TeamMacLean/Automator/hardware/Schematic Automator .pdf

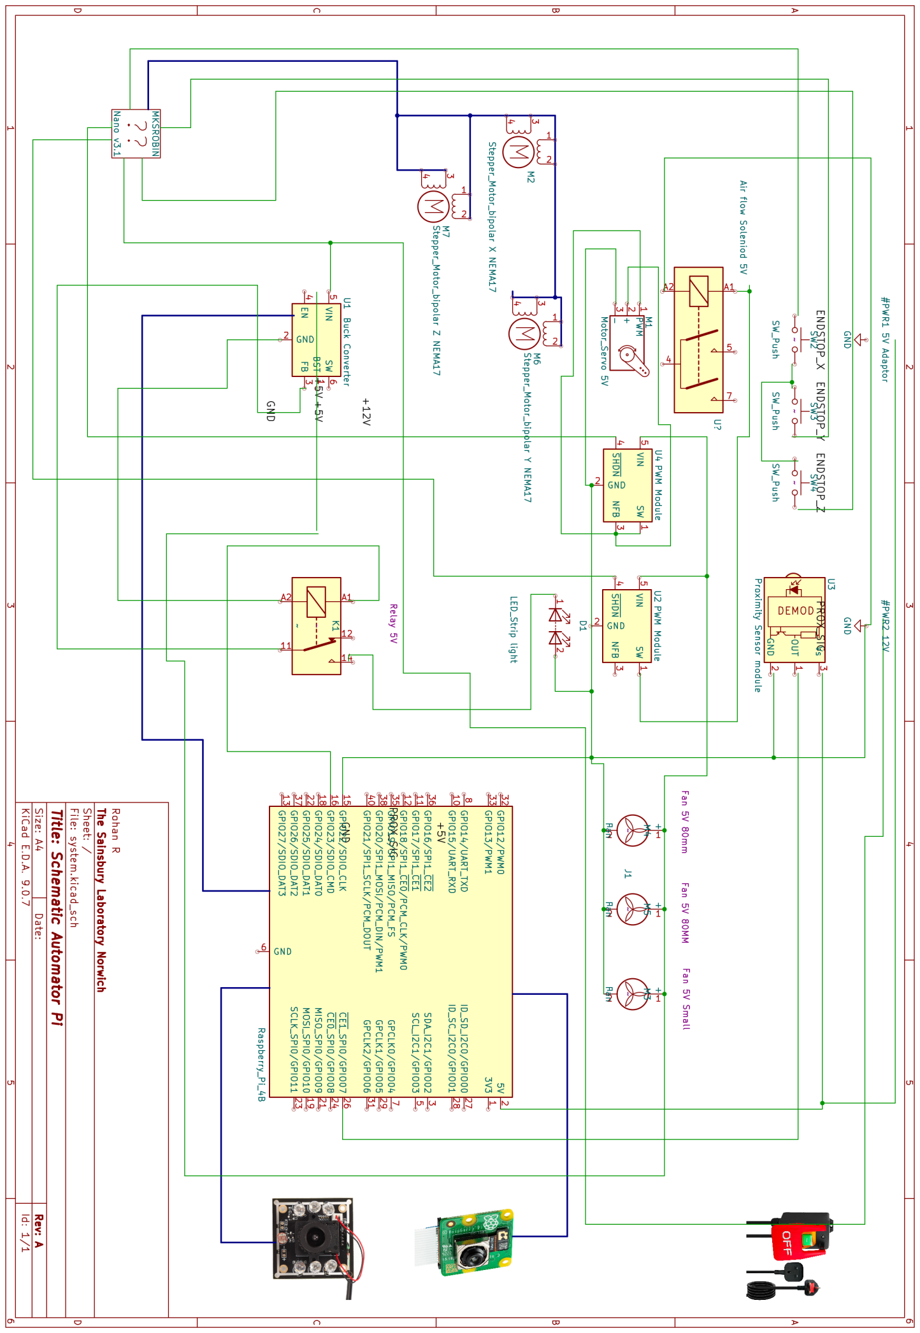
[picture p46: page 1]
