TeamMacLean/Automator/mechanical/LED_and_cam_case.stl

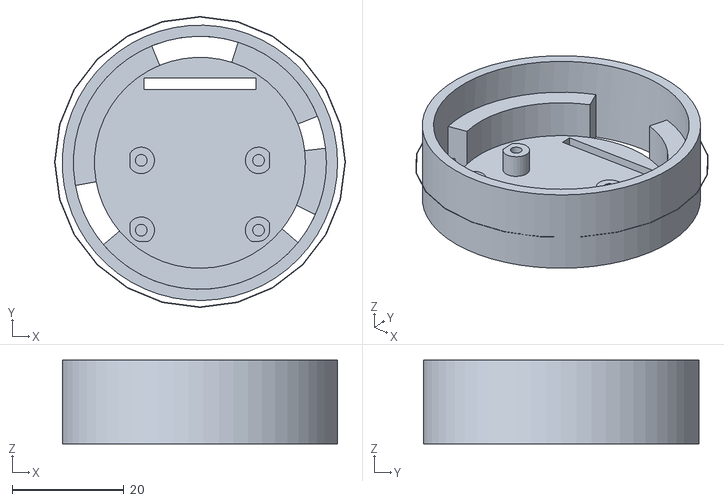
[picture p47: CAD file, 2026-07-26]
mechanical/LED_and_cam_case.stl
52.1 x 52.1 x 15.0
