TeamMacLean/Automator/mechanical/Base_LED_and_cam_case.stl

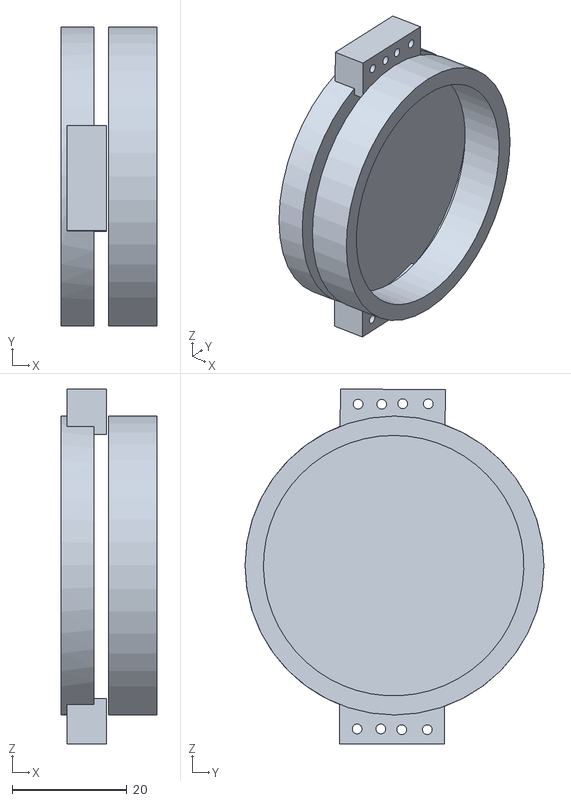
[picture p48: CAD file, 2026-07-26]
mechanical/Base_LED_and_cam_case.stl
16.7 x 52.0 x 61.8
