TeamMacLean/Automator/mechanical/Base_PIMKS.stl

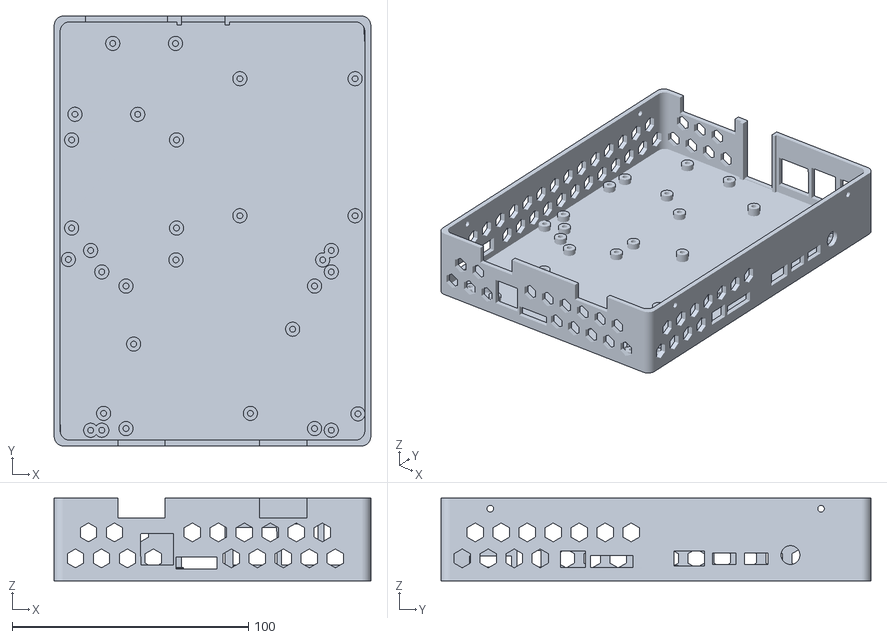
[picture p49: CAD file, 2026-07-26]
mechanical/Base_PIMKS.stl
134.0 x 182.0 x 35.0
