TeamMacLean/Automator/mechanical/Cover_80mm_Two_Fans.stl

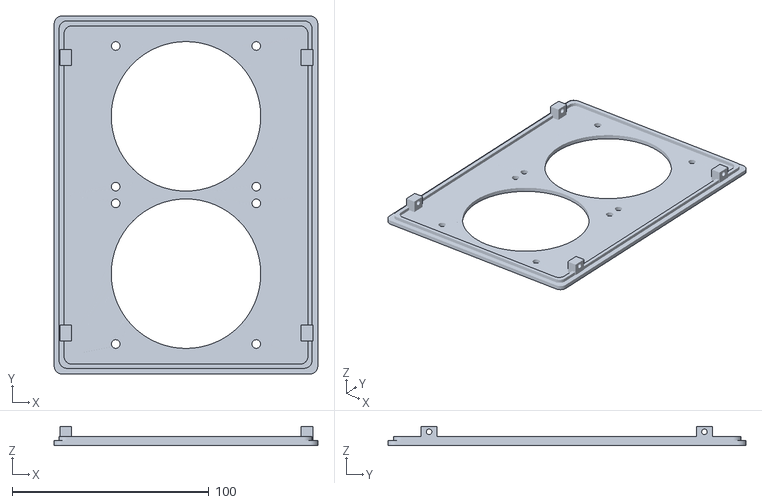
[picture p50: CAD file, 2026-07-26]
mechanical/Cover_80mm_Two_Fans.stl
134.0 x 182.0 x 9.68
