TeamMacLean/Automator/hardware/system schematic Automator.kicad_sch

## KiCad design hardware/system schematic Automator.kicad_sch (2026-07-26)

Schematic: system schematic Automator.kicad_sch

Parts:
D1: LED_Strip light
J1: Raspberry_Pi_4B
K1: (no value)
M1: Motor_Servo 5V
M2: Stepper_Motor_bipolar X NEMA17
M3, M4, M5: Fan
M6: Stepper_Motor_bipolar Y NEMA17
M7: Stepper_Motor_bipolar Z NEMA17
MKSROBIN: Nano v3.1
SW2, SW3, SW4: SW_Push
U1: Buck Converter; SOT-23-6
U2, U4: PWM Module; SOT-23-5
U3: Proximity Sensor module; Vishay_MINICAST-3Pin
