TeamMacLean/Automator/config/NetworkManager/preconfigured.nmcli.txt

connection.id:                          preconfigured
connection.uuid:                        e70013c7-5a59-4385-a157-2e4f6a428f69
connection.stable-id:                   --
connection.type:                        802-11-wireless
connection.interface-name:              --
connection.autoconnect:                 yes
connection.autoconnect-priority:        0
connection.autoconnect-retries:         -1 (default)
connection.multi-connect:               0 (default)
connection.auth-retries:                -1
connection.timestamp:                   1754864691
connection.read-only:                   no
connection.permissions:                 --
connection.zone:                        --
connection.master:                      --
connection.slave-type:                  --
connection.autoconnect-slaves:          -1 (default)
connection.secondaries:                 --
connection.gateway-ping-timeout:        <REDACTED>
connection.metered:                     unknown
connection.lldp:                        default
connection.mdns:                        -1 (default)
connection.llmnr:                       -1 (default)
connection.dns-over-tls:                -1 (default)
connection.mptcp-flags:                 0x0 (default)
connection.wait-device-timeout:         -1
connection.wait-activation-delay:       -1
802-11-wireless.ssid:                   SHELL-4CB4D3
802-11-wireless.mode:                   infrastructure
802-11-wireless.band:                   --
802-11-wireless.channel:                0
802-11-wireless.bssid:                  --
802-11-wireless.rate:                   0
802-11-wireless.tx-power:               0
802-11-wireless.mac-address:            --
802-11-wireless.cloned-mac-address:     --
802-11-wireless.generate-mac-address-mask:--
802-11-wireless.mac-address-blacklist:  --
802-11-wireless.mac-address-randomization:default
802-11-wireless.mtu:                    auto
802-11-wireless.seen-bssids:            8C:FD:DE:4C:B4:D1,8C:FD:DE:4C:B4:D0
802-11-wireless.hidden:                 no
802-11-wireless.powersave:              0 (default)
802-11-wireless.wake-on-wlan:           0x1 (default)
802-11-wireless.ap-isolation:           -1 (default)
802-11-wireless-security.key-mgmt:      wpa-psk
802-11-wireless-security.wep-tx-keyidx: 0
802-11-wireless-security.auth-alg:      --
802-11-wireless-security.proto:         --
802-11-wireless-security.pairwise:      --
802-11-wireless-security.group:         --
802-11-wireless-security.pmf:           0 (default)
802-11-wireless-security.leap-username: --
802-11-wireless-security.wep-key0:      <REDACTED>
802-11-wireless-security.wep-key1:      <REDACTED>
802-11-wireless-security.wep-key2:      <REDACTED>
802-11-wireless-security.wep-key3:      <REDACTED>
802-11-wireless-security.wep-key-flags: <REDACTED>
802-11-wireless-security.wep-key-type:  <REDACTED>
802-11-wireless-security.psk:           <REDACTED>
802-11-wireless-security.psk-flags:     <REDACTED>
802-11-wireless-security.leap-password: <REDACTED>
802-11-wireless-security.leap-password-flags:<REDACTED>
802-11-wireless-security.wps-method:    0x0 (default)
802-11-wireless-security.fils:          0 (default)
ipv4.method:                            auto
ipv4.dns:                               --
ipv4.dns-search:                        --
ipv4.dns-options:                       --
ipv4.dns-priority:                      0
ipv4.addresses:                         --
ipv4.gateway:                           --
ipv4.routes:                            --
ipv4.route-metric:                      -1
ipv4.route-table:                       0 (unspec)
ipv4.routing-rules:                     --
ipv4.replace-local-rule:                -1 (default)
ipv4.ignore-auto-routes:                no
ipv4.ignore-auto-dns:                   no
ipv4.dhcp-client-id:                    --
ipv4.dhcp-iaid:                         --
ipv4.dhcp-timeout:                      0 (default)
ipv4.dhcp-send-hostname:                yes
ipv4.dhcp-hostname:                     --
ipv4.dhcp-fqdn:                         --
ipv4.dhcp-hostname-flags:               0x0 (none)
ipv4.never-default:                     no
ipv4.may-fail:                          yes
ipv4.required-timeout:                  -1 (default)
ipv4.dad-timeout:                       -1 (default)
ipv4.dhcp-vendor-class-identifier:      --
ipv4.link-local:                        0 (default)
ipv4.dhcp-reject-servers:               --
ipv4.auto-route-ext-gw:                 -1 (default)
ipv6.method:                            auto
ipv6.dns:                               --
ipv6.dns-search:                        --
ipv6.dns-options:                       --
ipv6.dns-priority:                      0
ipv6.addresses:                         --
ipv6.gateway:                           --
ipv6.routes:                            --
ipv6.route-metric:                      -1
ipv6.route-table:                       0 (unspec)
ipv6.routing-rules:                     --
ipv6.replace-local-rule:                -1 (default)
ipv6.ignore-auto-routes:                no
ipv6.ignore-auto-dns:                   no
ipv6.never-default:                     no
ipv6.may-fail:                          yes
ipv6.required-timeout:                  -1 (default)
ipv6.ip6-privacy:                       -1 (unknown)
ipv6.addr-gen-mode:                     default
ipv6.ra-timeout:                        0 (default)
ipv6.mtu:                               auto
ipv6.dhcp-duid:                         --
ipv6.dhcp-iaid:                         --
ipv6.dhcp-timeout:                      0 (default)
ipv6.dhcp-send-hostname:                yes
ipv6.dhcp-hostname:                     --
ipv6.dhcp-hostname-flags:               0x0 (none)
ipv6.auto-route-ext-gw:                 -1 (default)
ipv6.token:                             <REDACTED>
proxy.method:                           none
proxy.browser-only:                     no
proxy.pac-url:                          --
proxy.pac-script:                       --
