TeamMacLean/Automator/(commit log)

2026-08-07 Add move procedure for relocating the Automator
    Shutdown, umbilical disconnection, and rebuild steps for moving the
    system out of the growth chamber to temporary storage.
2026-08-07 Record damage from 2026-08-07 move; flag move procedure as partly superseded
    The umbilical could not be withdrawn intact due to undocumented cable
    ties, inline splices, and knots in the as-built wiring. Wires were cut
    near connectors and the 3D-printed cradle was destroyed. Rebuild now
    requires re-termination, a re-printed cradle, and full recalibration.
