TeamMacLean/Automator/(notices)

Notices in the files:
README.md:
Hardware License: CERN-OHL-S-2.0
Docs License: CC BY 4.0
