TeamMacLean/Automator/hardware/images/estop.jpg

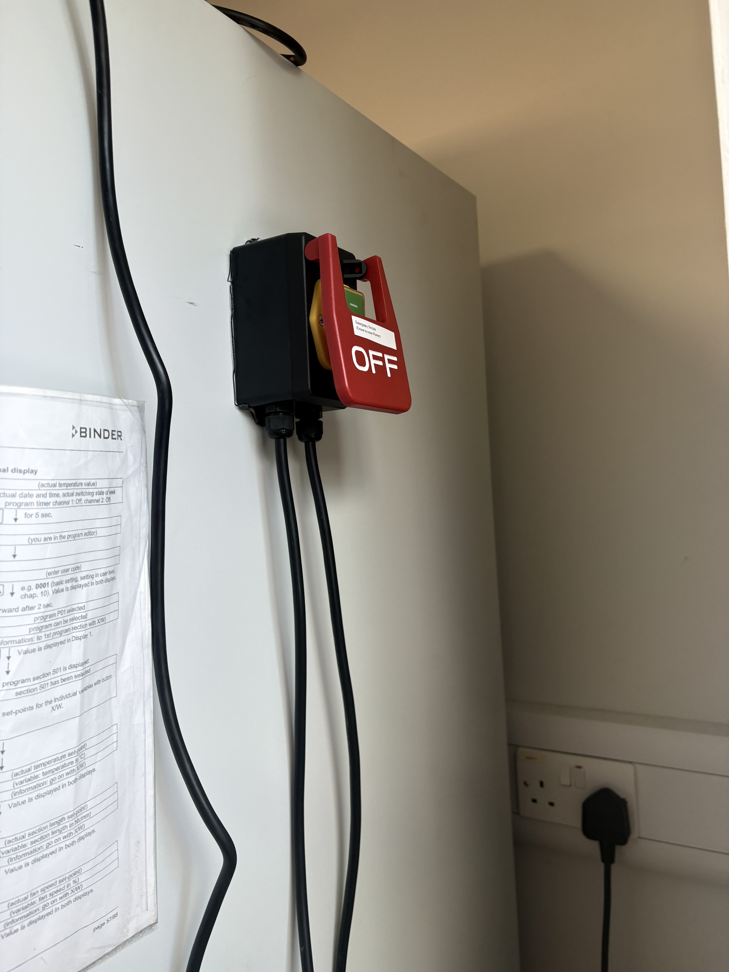
[picture p6: hardware/images/estop.jpg]
hardware/images/estop.jpg
