TeamMacLean/Automator/mechanical/IMG_5643.JPG

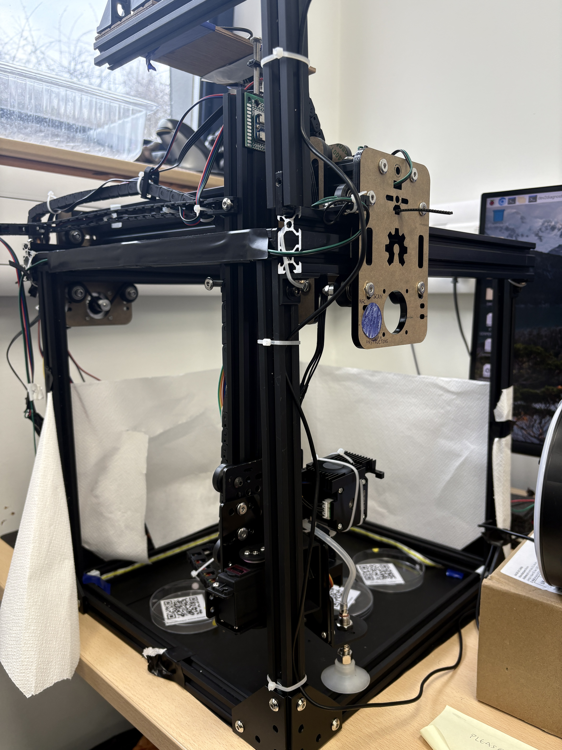
[picture p69: mechanical/IMG_5643.JPG]
mechanical/IMG_5643.JPG
