TeamMacLean/Automator/mechanical/IMG_5644.JPG

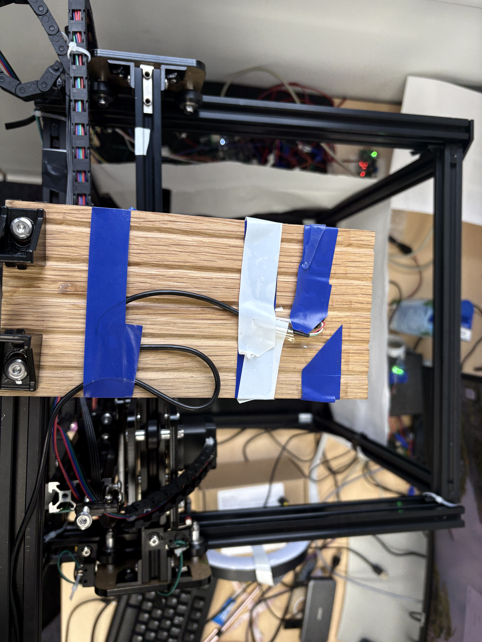
[picture p70: mechanical/IMG_5644.JPG]
mechanical/IMG_5644.JPG
