TeamMacLean/Automator/mechanical/IMG_5645.JPG

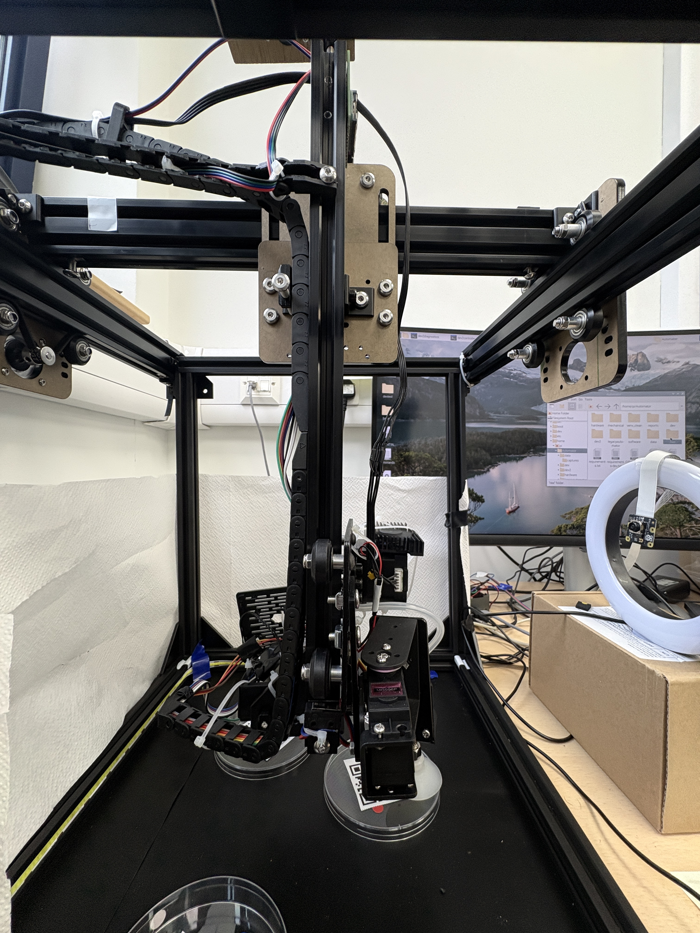
[picture p71: mechanical/IMG_5645.JPG]
mechanical/IMG_5645.JPG
