TeamMacLean/Automator/mechanical/IMG_5646.JPG

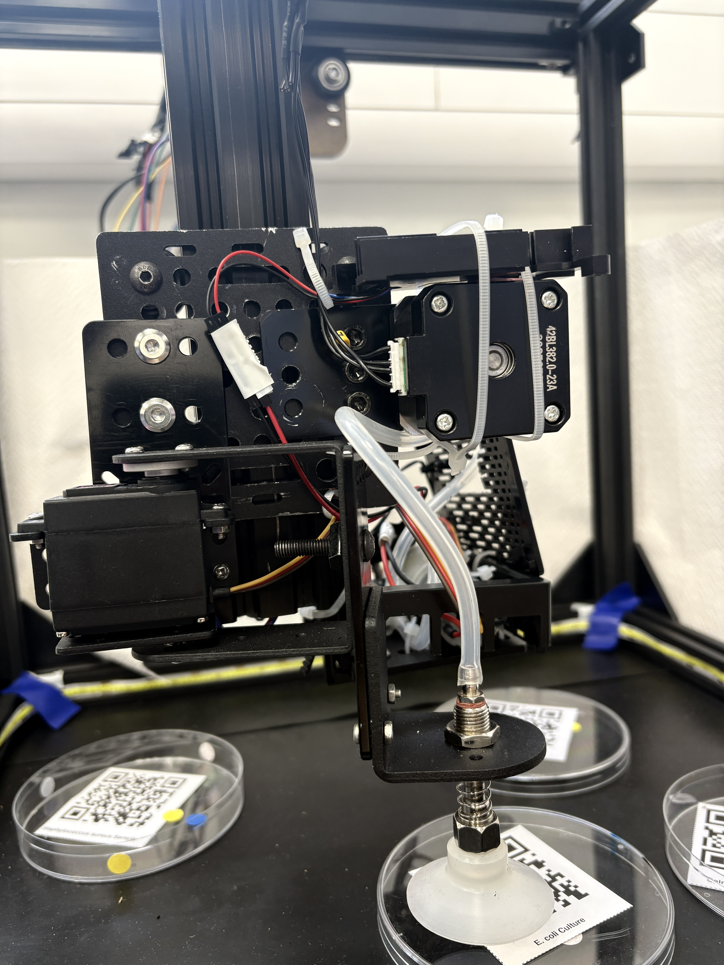
[picture p72: mechanical/IMG_5646.JPG]
mechanical/IMG_5646.JPG
