TeamMacLean/Automator/mechanical/IMG_5647.JPG

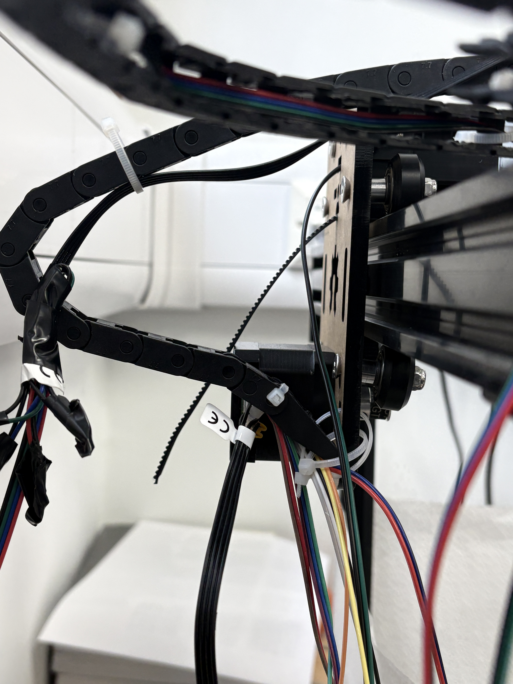
[picture p73: mechanical/IMG_5647.JPG]
mechanical/IMG_5647.JPG
